jlcjak/fastest_kettle/cad/step/terminal.step

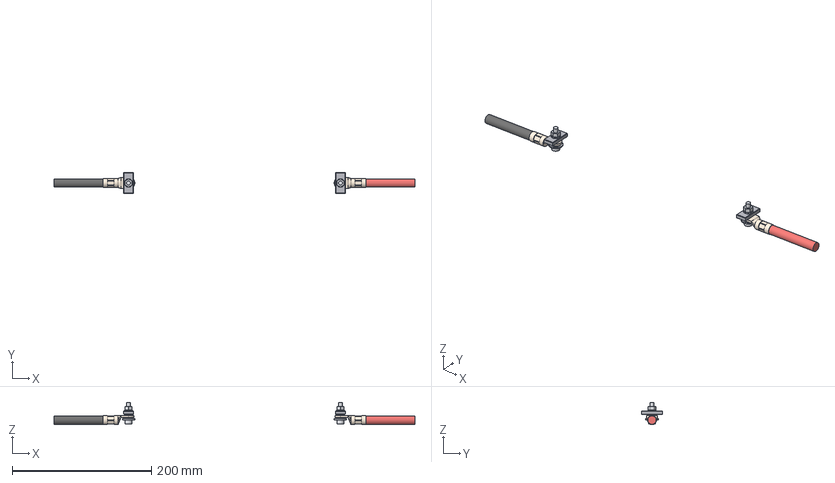
[picture p13: CAD file, 2026-11-10]
cad/step/terminal.step
518.0 x 30.0 x 31.9 mm
m6x25_terminal_bolts_1
m6x25_terminal_bolts_2
m6_washers_d18_1
m6_washers_d18_2
shoulder_washers_1
shoulder_washers_2
backing_plates_steel_1
backing_plates_steel_2
m6_top_washers_1
m6_top_washers_2
m6_nuts_1
m6_nuts_2
lug_35_m8_A
lug_35_m8_B
cable_A_pos
cable_B_neg
