jlcjak/fastest_kettle/cad/stl/centering_jig_block_print_x4.stl

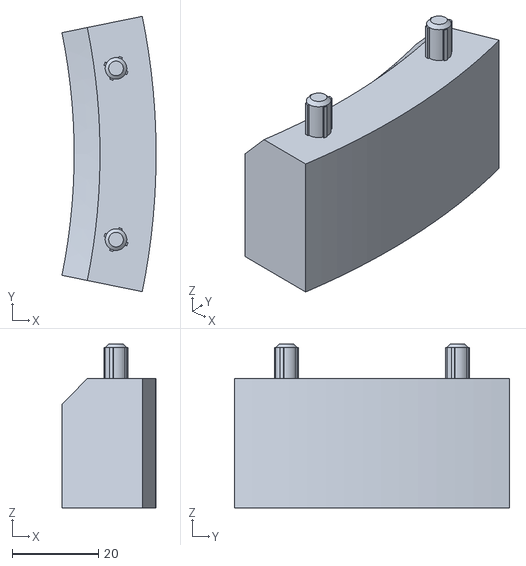
[picture p14: CAD file, 2026-11-10]
cad/stl/centering_jig_block_print_x4.stl
21.8 x 63.8 x 38.0
