jlcjak/fastest_kettle/cad/stl/foot_PC_print_x4.stl

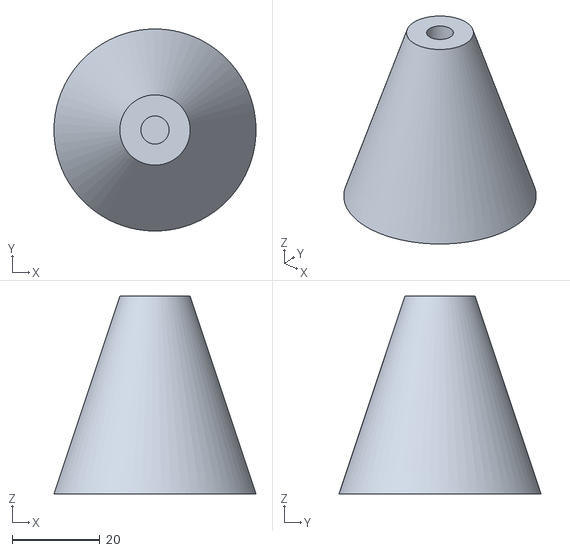
[picture p15: CAD file, 2026-11-10]
cad/stl/foot_PC_print_x4.stl
46.0 x 46.0 x 45.0
