jlcjak/fastest_kettle/cad/step/kettle_exploded.step

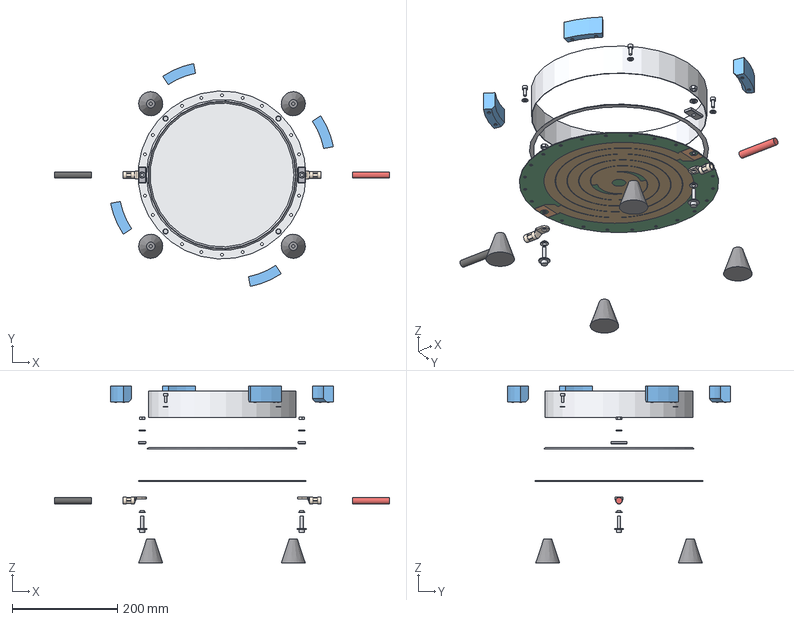
[picture p16: CAD file, 2026-11-10]
cad/step/kettle_exploded.step
638.0 x 424.6 x 336.6 mm
heater_aluminium
heater_dielectric_mask
heater_copper_masked
heater_contact_pads_1
heater_contact_pads_2
cake_ring_304
silicone_sealant
m6x25_terminal_bolts_1
m6x25_terminal_bolts_2
m6_washers_d18_1
m6_washers_d18_2
shoulder_washers_1
shoulder_washers_2
backing_plates_steel_1
backing_plates_steel_2
m6_top_washers_1
m6_top_washers_2
m6_nuts_1
m6_nuts_2
lug_35_m8_A
lug_35_m8_B
cable_A_pos
cable_B_neg
foot_045
foot_135
foot_225
foot_315
jig_block_022
jig_block_112
jig_block_202
jig_block_292
m5x12_foot_bolts_1
m5x12_foot_bolts_2
m5x12_foot_bolts_3
m5x12_foot_bolts_4
m5_foot_washers_1
m5_foot_washers_2
m5_foot_washers_3
m5_foot_washers_4
