jlcjak/fastest_kettle/cad/step/feet.step

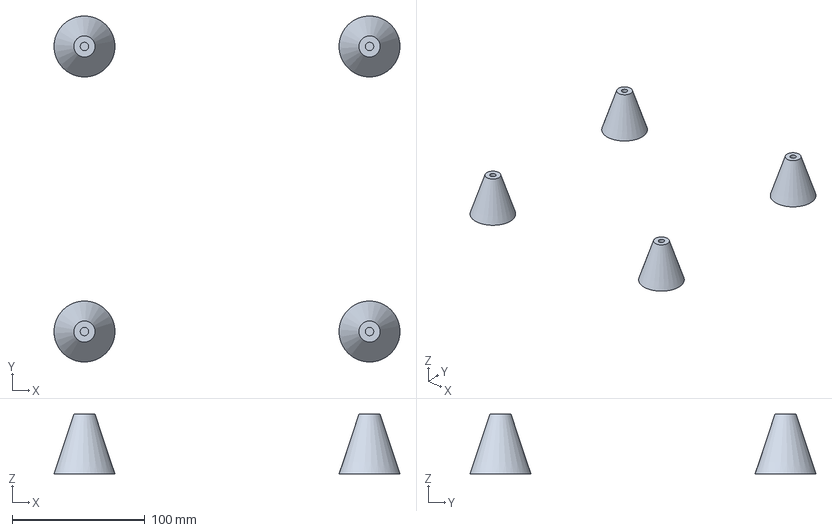
[picture p17: CAD file, 2026-11-10]
cad/step/feet.step
260.9 x 260.9 x 45.0 mm
foot_045
foot_135
foot_225
foot_315
