jlcjak/fastest_kettle/cad/step/cake_ring.step

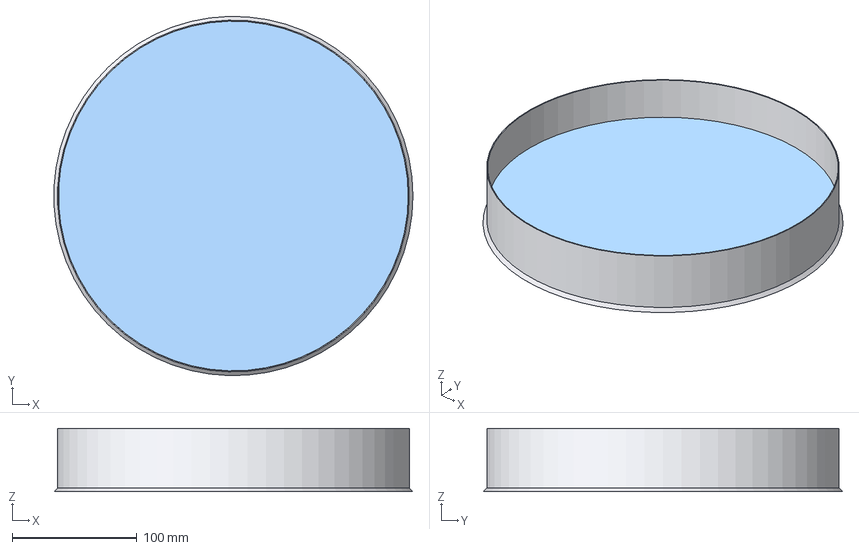
[picture p18: CAD file, 2026-11-10]
cad/step/cake_ring.step
287.4 x 287.5 x 50.5 mm
cake_ring_304
silicone_sealant
water_1L
