jlcjak/fastest_kettle/cad/step/centering_jig.step

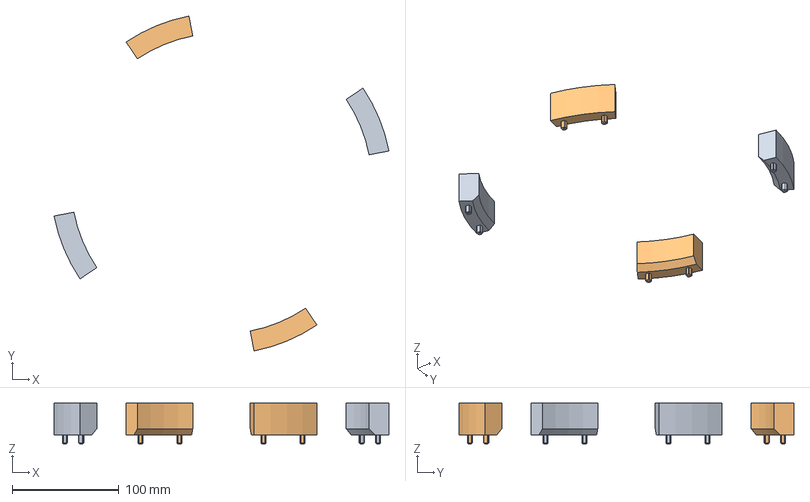
[picture p19: CAD file, 2026-11-10]
cad/step/centering_jig.step
314.1 x 314.1 x 38.0 mm
jig_block_022
jig_block_112
jig_block_202
jig_block_292
