jlcjak/fastest_kettle/cad/step/lug_35_m8.step

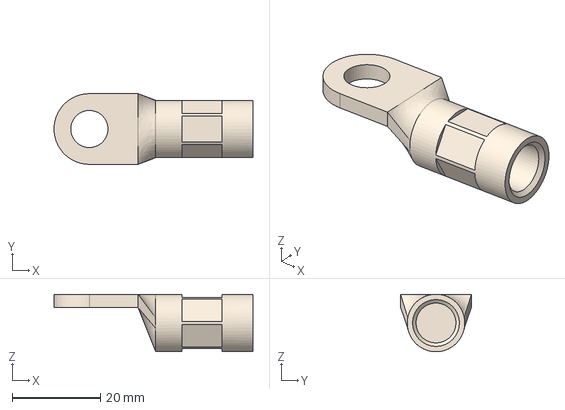
[picture p20: CAD file, 2026-11-10]
cad/step/lug_35_m8.step
45.0 x 16.0 x 13.0 mm
