jlcjak/fastest_kettle/cad/step/heater_board.step

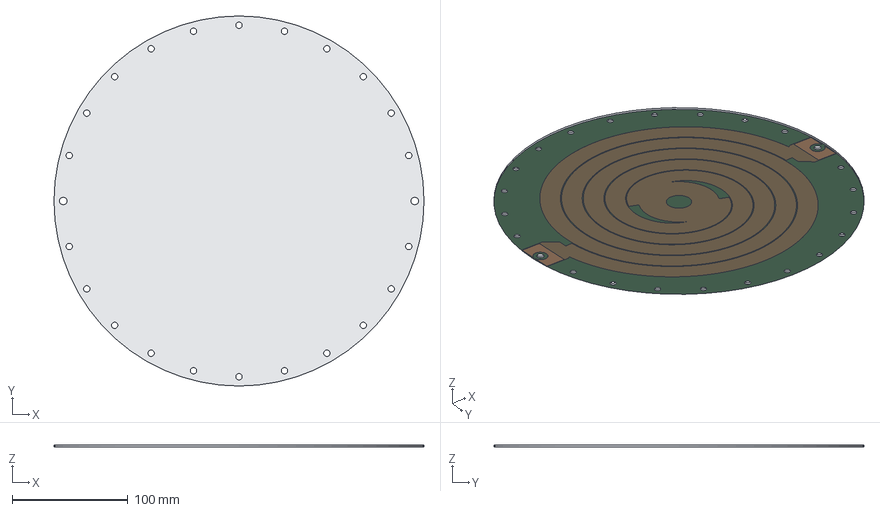
[picture p21: CAD file, 2026-11-10]
cad/step/heater_board.step
320.0 x 320.0 x 1.60 mm
heater_aluminium
heater_dielectric_mask
heater_copper_masked
heater_contact_pads_1
heater_contact_pads_2
