jlcjak/fastest_kettle/(commit log)

2026-11-10 The Fastest Kettle: 1 L boiled in 29.5 s on car batteries
    Aluminium-core PCB heater (65 mOhm copper spiral) as the pot floor,
    stainless cake ring siliconed on top, 4 used car batteries at 48 V /
    ~400 A through two EV200 contactors. Includes the KiCad heater and
    gerbers, CAD (STEP, STL, FreeCAD scripts), simulations, build guide and
    the Nov 2026 test results.
    [cake_ring.step, centering_jig.step, centering_jig_block_print_x4.stl, feet.step, foot_PC_print_x4.stl, heater.kicad_pcb, heater_board.step, kettle_assembly.step]
2026-11-10 Feet are optional; tie the kettle down because of the stiff 35 mm² cables
